TeamClockworks-RO108/Blobifier/User mods/A4T Toolhead Shaker Arm and Shaker/CAD/Shaker_Arm_A4T_flat_with_deck.step

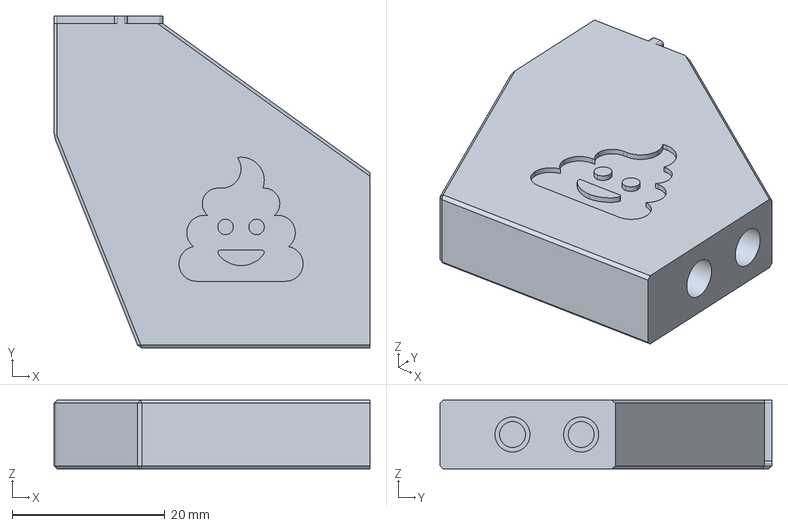
[picture p10: CAD file, 2025-11-11]
User mods/A4T Toolhead Shaker Arm and Shaker/CAD/Shaker_Arm_A4T_flat_with_deck.step
41.4 x 43.5 x 9.00 mm
