TeamClockworks-RO108/Blobifier/User mods/A4T Toolhead Shaker Arm and Shaker/STL/Shaker_A4T.stl

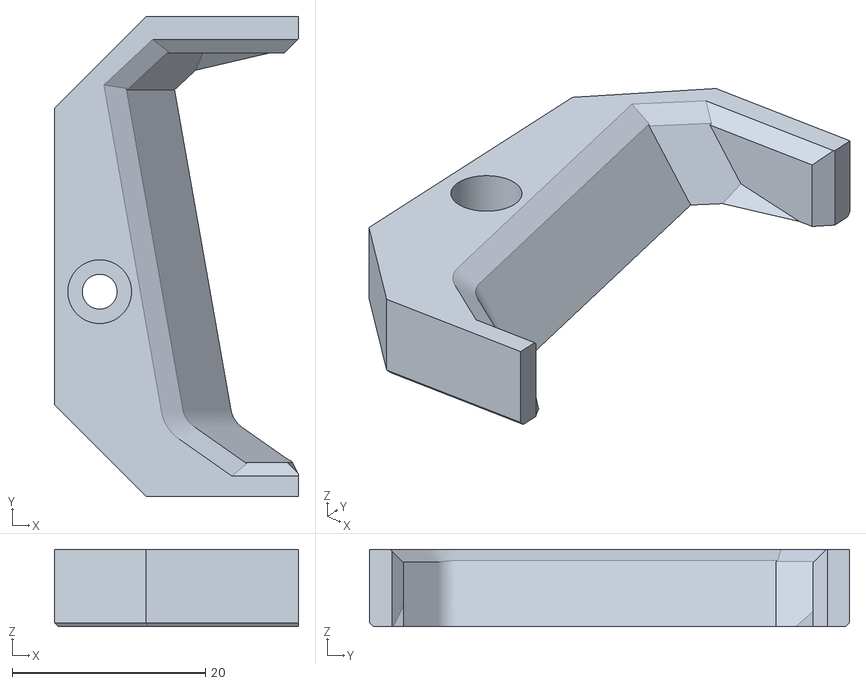
[picture p11: CAD file, 2025-11-11]
User mods/A4T Toolhead Shaker Arm and Shaker/STL/Shaker_A4T.stl
25.3 x 49.7 x 8.00
