TeamClockworks-RO108/Blobifier/User mods/Stepper Blobifier/CAD/Blobifier v19.step

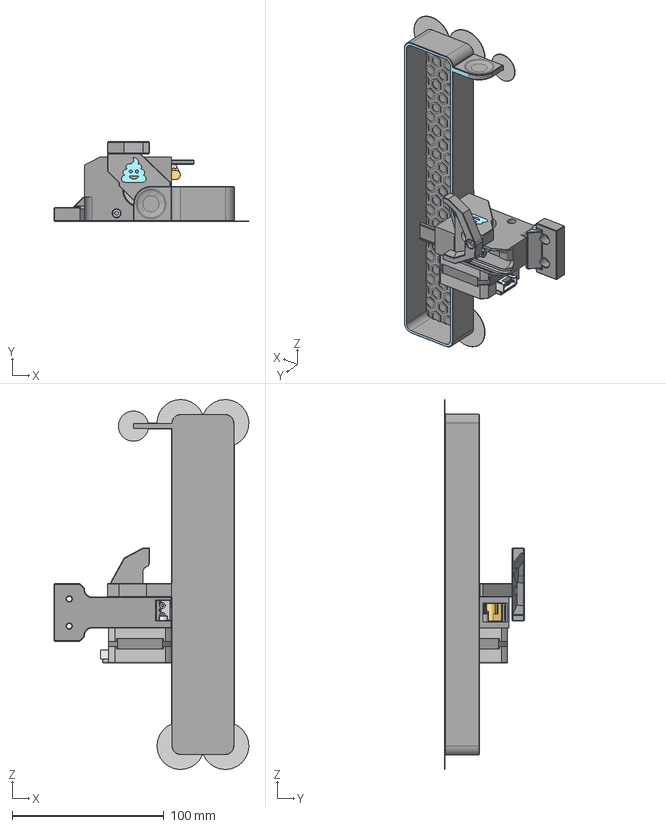
[picture p12: CAD file, 2025-11-06]
User mods/Stepper Blobifier/CAD/Blobifier v19.step
128.6 x 52.5 x 244.2 mm
Tray
Bucket
Shaker
Arm
Mount_voron_2.4 5mm wider bed
back_plate
front_plate
stator
625ZZ x 2
rotor
connector
M3_screw x 4
GT2 20T 6MM Pulley
Tensioner
BeltSupport
DIN 7991 - M3x6 Stainless Steel A2 Plain x 2
StepperHousing
D2F_FL_D.BASE
D2F_FL_D_ACTUATOR
DIN 912 - M3 x 0.5 x 10 Stainless Steel A2 Plain
DIN 912 - M3 x 0.5 x 8 Stainless Steel A2 Plain x 2
DIN 912 - M2 x 0.4 x 10 Stainless Steel A2 Plain x 2
