TeamClockworks-RO108/Blobifier/User mods/Stepper Blobifier/STL/Tray.stl

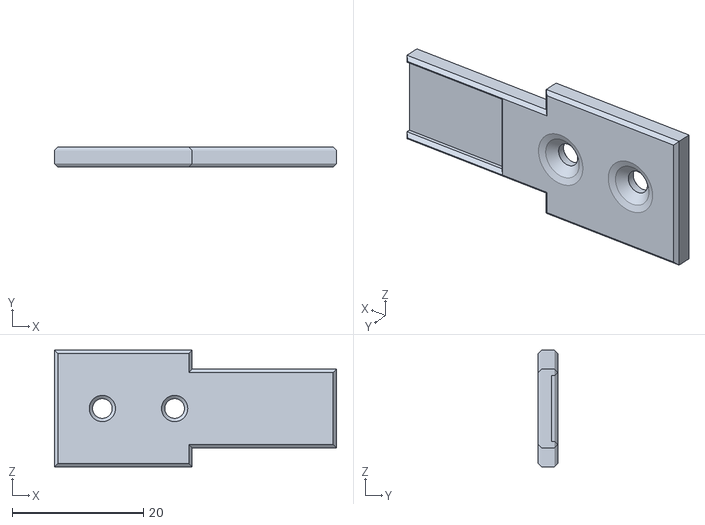
[picture p13: CAD file, 2025-11-06]
User mods/Stepper Blobifier/STL/Tray.stl
43.0 x 3.00 x 17.8
