TeamClockworks-RO108/Blobifier/User mods/A4T Toolhead Shaker Arm and Shaker/CAD/Shaker_A4T_tighter_fit.step

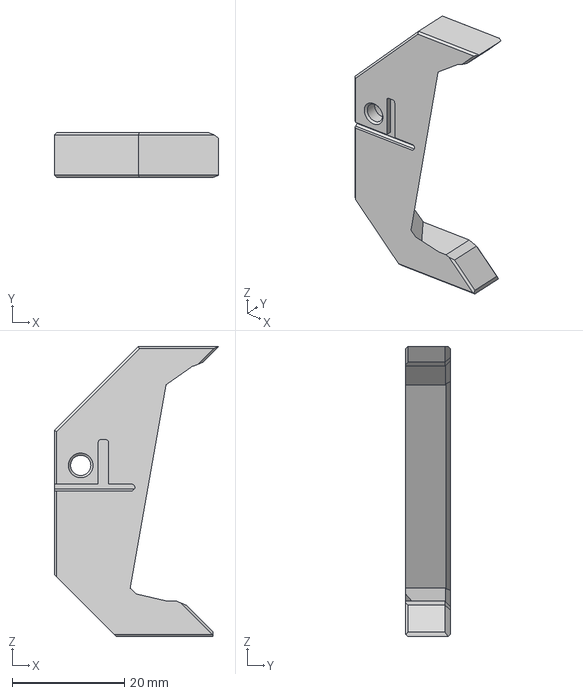
[picture p14: CAD file, 2025-09-05]
User mods/A4T Toolhead Shaker Arm and Shaker/CAD/Shaker_A4T_tighter_fit.step
29.3 x 8.01 x 51.7 mm
