TeamClockworks-RO108/Blobifier/User mods/A4T Toolhead Shaker Arm and Shaker/STL/Shaker_Arm_A4T.stl

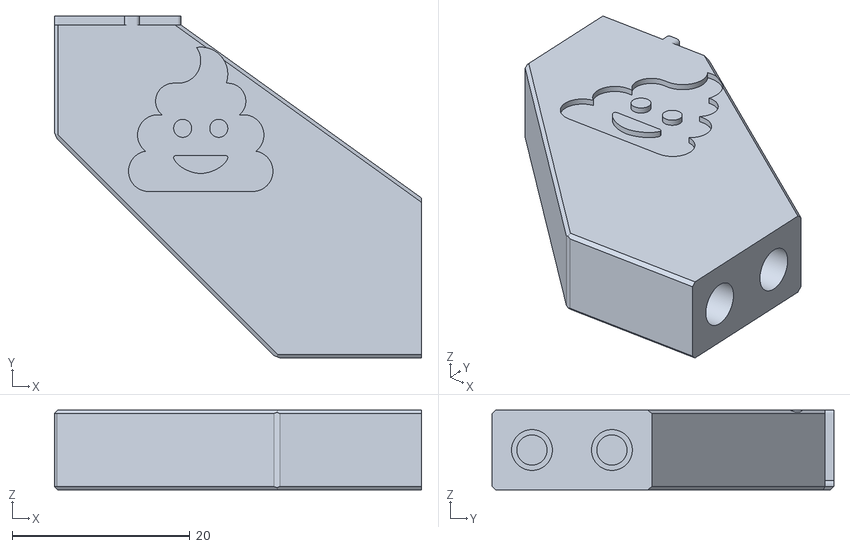
[picture p15: CAD file, 2025-11-11]
User mods/A4T Toolhead Shaker Arm and Shaker/STL/Shaker_Arm_A4T.stl
41.4 x 38.5 x 9.00
