TeamClockworks-RO108/Blobifier/User mods/Stepper Blobifier/STL/Arm.stl

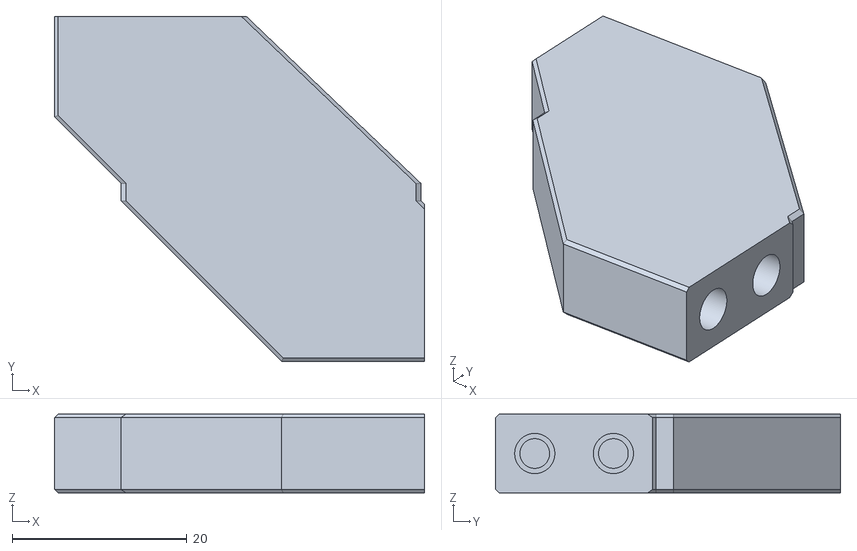
[picture p16: CAD file, 2025-11-06]
User mods/Stepper Blobifier/STL/Arm.stl
42.4 x 39.5 x 9.00
