TeamClockworks-RO108/Blobifier/User mods/Stepper Blobifier/STL/StepperHousing.stl

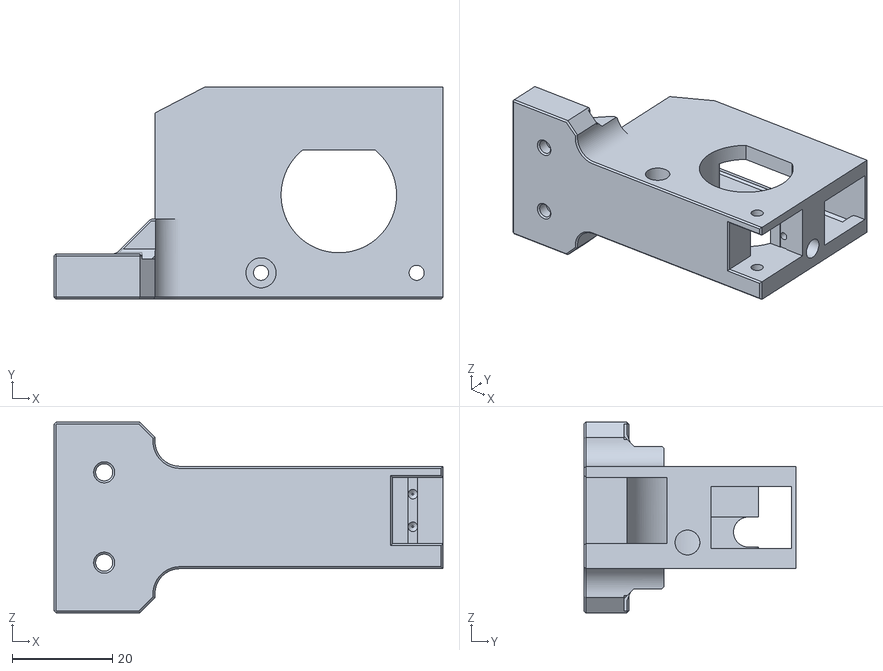
[picture p17: CAD file, 2025-11-06]
User mods/Stepper Blobifier/STL/StepperHousing.stl
77.5 x 42.3 x 38.0
