TeamClockworks-RO108/Blobifier/User mods/Stepper Blobifier/STL/Tensioner.stl

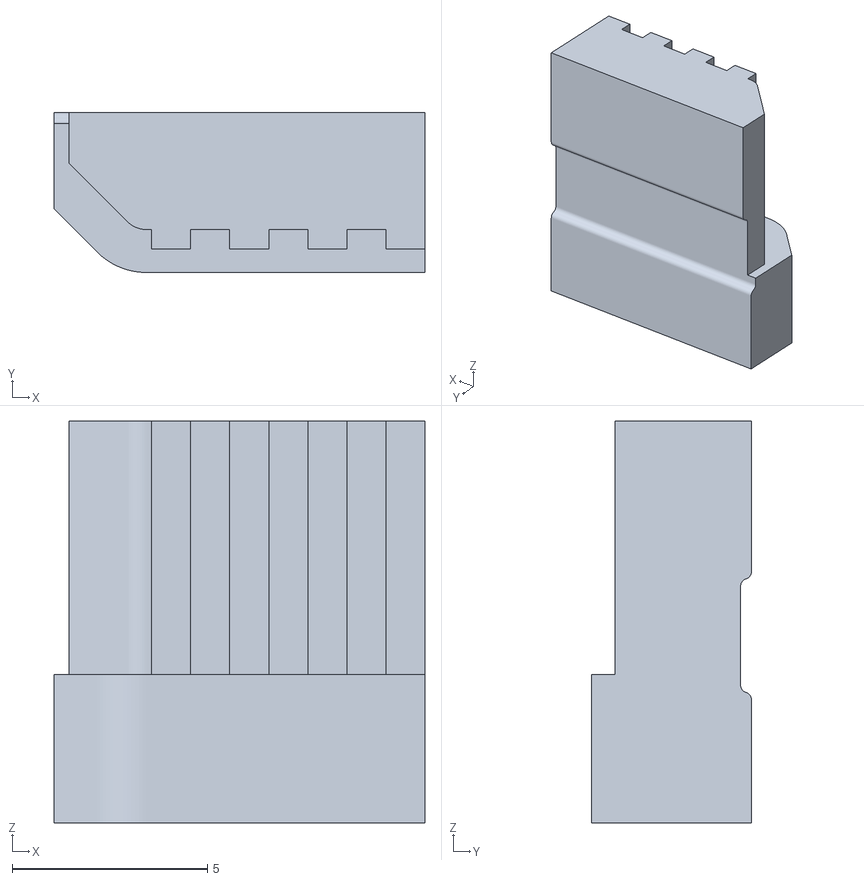
[picture p18: CAD file, 2025-11-06]
User mods/Stepper Blobifier/STL/Tensioner.stl
9.50 x 4.10 x 10.3
