TeamClockworks-RO108/Blobifier/User mods/Stepper Blobifier/STL/BeltSupport.stl

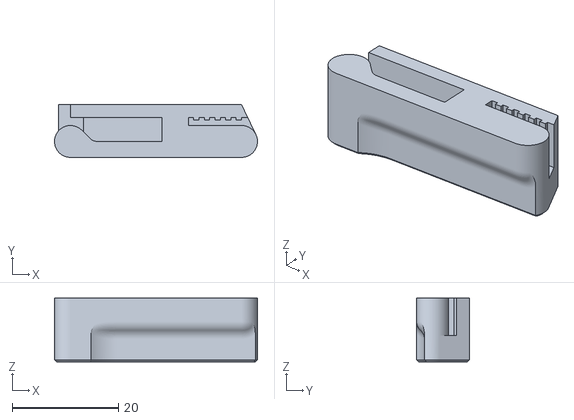
[picture p19: CAD file, 2025-11-06]
User mods/Stepper Blobifier/STL/BeltSupport.stl
38.2 x 9.93 x 12.0
