TeamClockworks-RO108/Blobifier/(list of files, cad)

Other CAD files:
User mods/A4T Toolhead Shaker Arm and Shaker/STL/Shaker_A4T_tighter_fit.stl
User mods/A4T Toolhead Shaker Arm and Shaker/STL/Shaker_Arm_A4T_flat_with_deck.stl
