TeamClockworks-RO108/Blobifier/(commit log)

2025-11-06 Add STL files
    [Arm.stl, BeltSupport.stl, StepperHousing.stl, Tensioner.stl]
2025-11-06 Add STEP CAD
    [Blobifier v19.step]
2025-11-06 Add Fusion file
    [Tray.stl]
2025-11-06 Add tray stl
    [Tray.stl]
2025-11-06 Fix duplicate files
    [Tray.stl]
2025-11-07 Add screws to bom for d2f switch
2025-11-07 Add mention for open stepper slot
2025-11-07 Add assembly images
2025-11-07 Finish assembly instructions
